emilylinchan/tof-spatial-mapping/inc/onboardLEDs.h

void FlashLED1(int count);
void FlashLED2(int count);
void FlashLED3(int count);
void FlashLED4(int count);

void FlashAllLEDs(void);

void Flash_UART_Tx(void);
void Flash_Measurement_Status(void);
void MovingLED(int on);

void onboardLEDs_Init(void);
